Raphael-Boichot/Play-with-the-Game-Boy-Camera-Mitsubishi-M64282FP-sensor/ESP32_version_beta/Project schematics.pptx

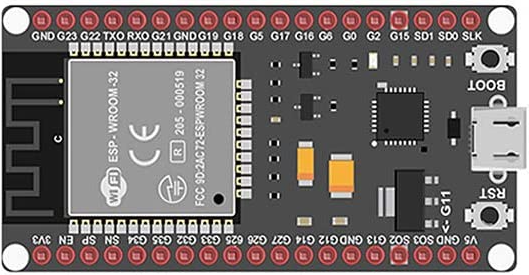
[picture p8: figure]

CAM_VOUT

CAM_GND

CAM_VCC

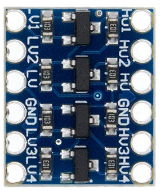
[picture p9: figure]

CAM_READ

CAM_CLOCK

+3.3V

CAM_RESET

CAM_SIN

CAM_LOAD

+5V

CAM_START

START

SIN

LOAD

RESET

CLOCK

READ

FREE

FREE

FREE

FREE

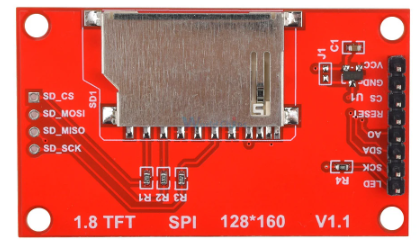
[picture p10: figure]

Main ON/OFF
