Raphael-Boichot/Play-with-the-Game-Boy-Camera-Mitsubishi-M64282FP-sensor/Additionnal informations/Arduicam_172.png

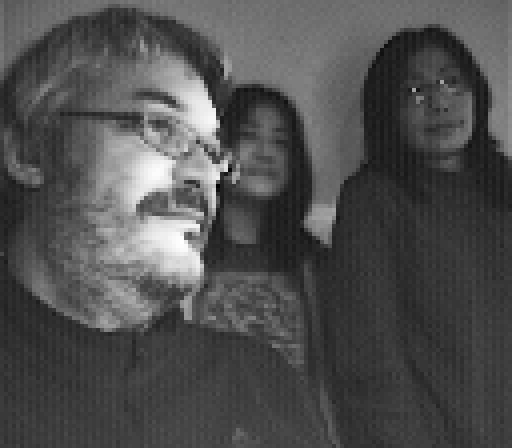
Additionnal informations/Arduicam_172.png
