Raphael-Boichot/Play-with-the-Game-Boy-Camera-Mitsubishi-M64282FP-sensor/Additionnal informations/First_try.gif

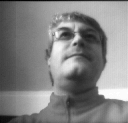
Additionnal informations/First_try.gif
