Raphael-Boichot/Play-with-the-Game-Boy-Camera-Mitsubishi-M64282FP-sensor/Additionnal informations/setting.png

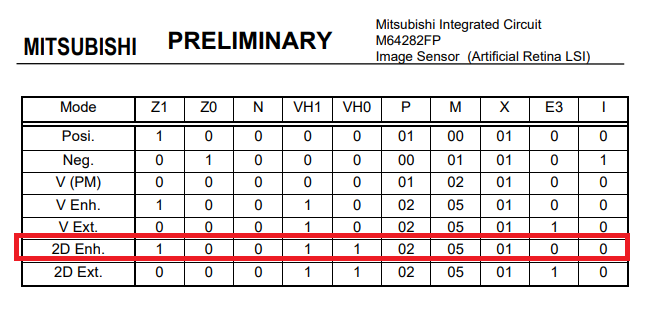
Additionnal informations/setting.png
