Raphael-Boichot/Play-with-the-Game-Boy-Camera-Mitsubishi-M64282FP-sensor/Arduino_Japanese_code_2012/32x32_Japanese_code.png

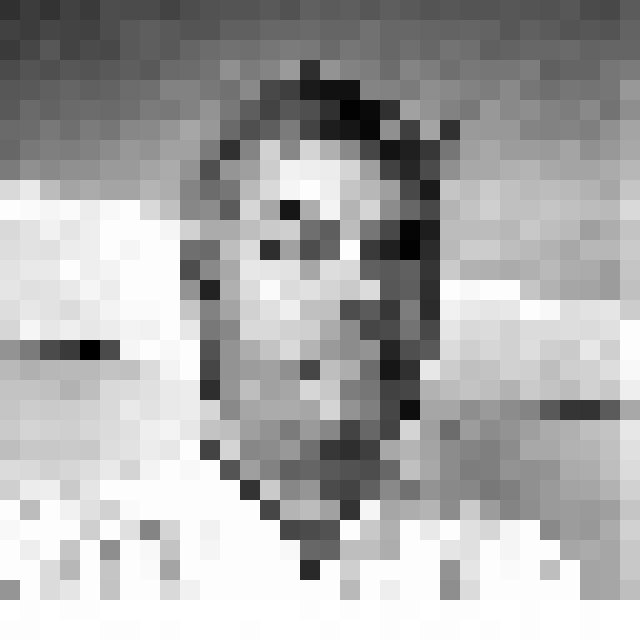
Arduino_Japanese_code_2012/32x32_Japanese_code.png
