Raphael-Boichot/Play-with-the-Game-Boy-Camera-Mitsubishi-M64282FP-sensor/ESP32_version_beta/ESP32_schematic.png

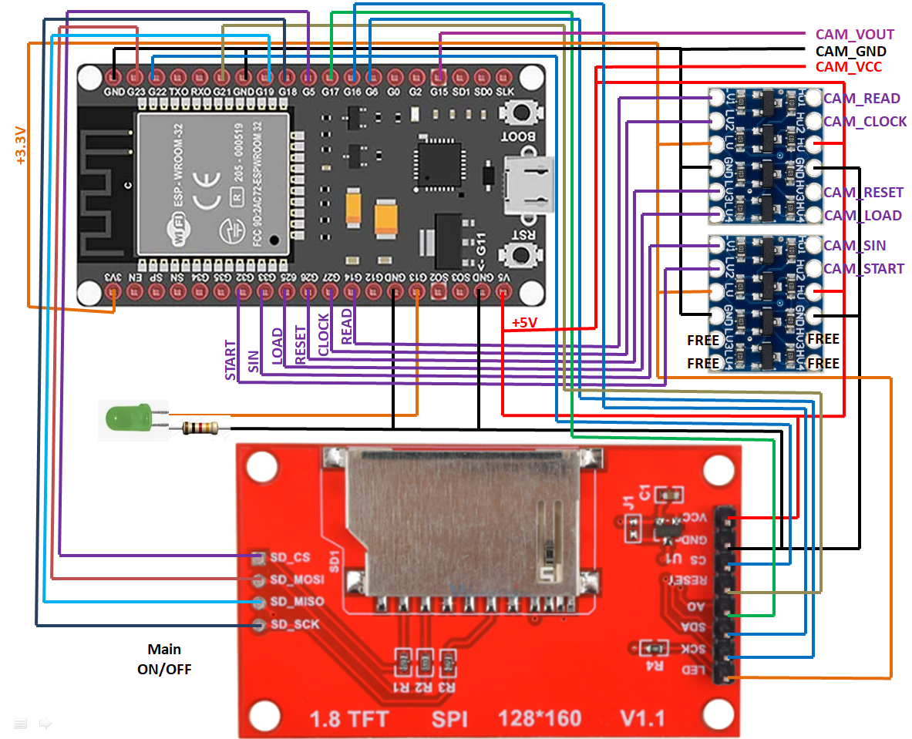
ESP32_version_beta/ESP32_schematic.png
