Raphael-Boichot/Play-with-the-Game-Boy-Camera-Mitsubishi-M64282FP-sensor/ESP32_version_beta/Image_taken_with_ESP32.png

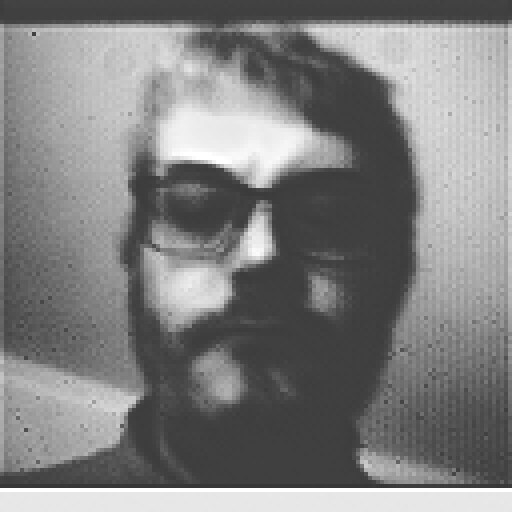
ESP32_version_beta/Image_taken_with_ESP32.png
