Raphael-Boichot/Play-with-the-Game-Boy-Camera-Mitsubishi-M64282FP-sensor/ESP32_version_beta/Screen_used.png

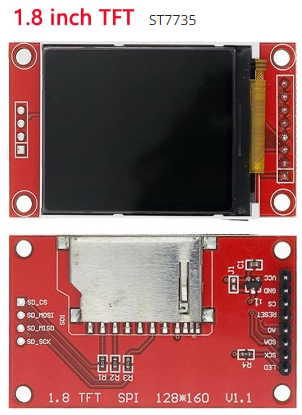
ESP32_version_beta/Screen_used.png
