Raphael-Boichot/Play-with-the-Game-Boy-Camera-Mitsubishi-M64282FP-sensor/Research on real Camera/Reverse_engineering.jpg

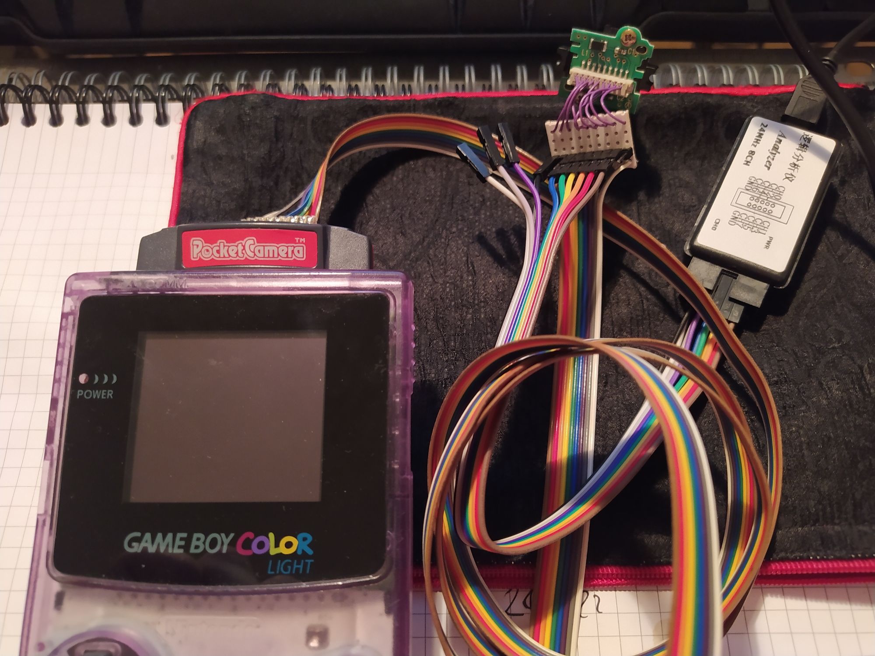
Research on real Camera/Reverse_engineering.jpg
