Raphael-Boichot/Play-with-the-Game-Boy-Camera-Mitsubishi-M64282FP-sensor/Research on real camera 2024/Calibration_procedure.xlsx

Sheet: Sheet1
Edge Exclusive | Edge Operation | Edge Enhancement Ratio | Zero Point Calibration | Invert | Exposure Time A | Exposure Time B | Exposure Time (ms) | Output Ref Voltage | Output node bias voltage | Analog output gain | Reg. Addr | 0x001 |  |  |  |  |  |  |  | 0x010 |  |  |  |  |  |  |  | 0x011 |  |  |  |  |  |  |  | 0x100 |  |  |  |  |  |  |  | 0x101 |  |  |  |  |  |  |  | 0x110
N | VH1 VH0 | E3 E2 E1 E0 | Z1 Z0 | I | C17 - C10 | C07 - C00 | C (all) | O5 O4 O3 O2 O1 O0 | V2 V1 V0 | G4 G3 G2 G1 G0 | Reg. Name | N | VH1 | VH0 | G4 | G3 | G2 | G1 | G0 | C17 | C16 | C15 | C14 | C13 | C12 | C11 | C10 | C07 | C06 | C05 | C04 | C03 | C02 | C01 | C00 | P7 | P6 | P5 | P4 | P3 | P2 | P1 | P0 | M7 | M6 | M5 | M4 | M3 | M2 | M1 | M0 | X7 | X6 | X5 | X4 | X3 | X2 | X1 | X0
0 | 1 | 0 | 2 | 0 | 0 | 48 | 0.768 | 31 | 3 | 0 |  | 0 | 0 | 1 | 0 | 0 | 0 | 0 | 0 | 0 | 0 | 0 | 0 | 0 | 0 | 0 | 0 | 0 | 0 | 1 | 1 | 0 | 0 | 0 | 0 | 0 | 0 | 0 | 0 | 0 | 0 | 0 | 1 | 0 | 0 | 0 | 0 | 0 | 0 | 0 | 0 | 0 | 0 | 0 | 0 | 0 | 0 | 0 | 1
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
