Raphael-Boichot/Play-with-the-Game-Boy-Camera-Mitsubishi-M64282FP-sensor/Additionnal informations/Testing_the_code.jpg

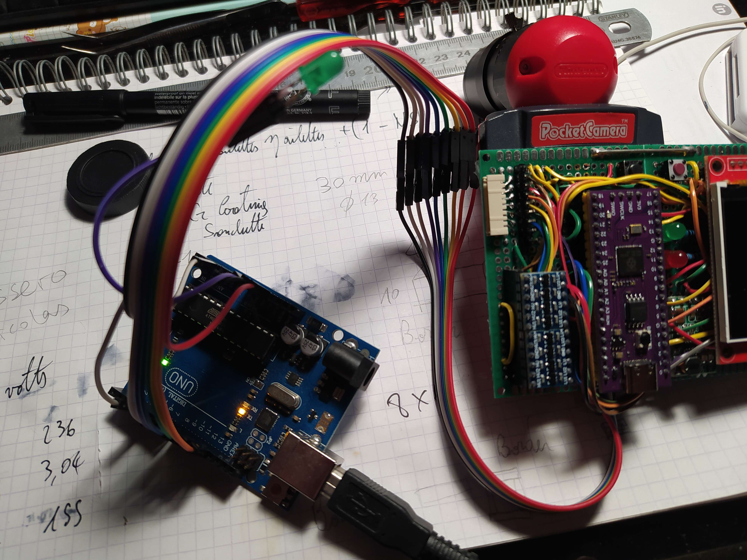
Additionnal informations/Testing_the_code.jpg
