Raphael-Boichot/Play-with-the-Game-Boy-Camera-Mitsubishi-M64282FP-sensor/(list of files, drawings)

Other design files:
PCB/PCB_Play-with-Mitsubishi-sensor_2024-03-31.json
