Raphael-Boichot/Play-with-the-Game-Boy-Camera-Mitsubishi-M64282FP-sensor/(commit log)

2024-05-27 PCB update with red LED
    [PCB_Play-with-Mitsubishi-sensor_2024-03-31.json]
2024-10-30 Some recent research added
    [00_save.xlsx, Blank.xlsx, Calibration_procedure.xlsx, Exposure_strategy_Debagame.xlsx, Exposure_strategy_Hello_Kitty.xlsx, Exposure_strategy_regular_camera.xlsx, Exposure_strategy_regular_camera_volts.xlsx, Register_storage.xlsx]
